tdwgithub/dih-dah-blue/hardware/paddle/Paddle-BOM.csv

Refs | Value | Footprint | Qty | Datasheet
C1 | 0.1uF | Capacitor_THT:C_Disc_D3.0mm_W1.6mm_P2.50mm | 1 | ~
D1 | ~ | LED_THT:LED_D3.0mm_Horizontal_O1.27mm_Z6.0mm | 1 | ~
J1,J4 | Conn_01x02_Pin | Connector_PinHeader_2.54mm:PinHeader_1x02_P2.54mm_Vertical | 2 | ~
J3 | Conn_01x02 | Connector_JST:JST_PH_S2B-PH-K_1x02_P2.00mm_Horizontal | 1 | ~
J5 | Screw_Terminal_01x03 | Wurth:691313510003 | 1 | ~
R1,R2 | 100K | Resistor_THT:R_Axial_DIN0207_L6.3mm_D2.5mm_P10.16mm_Horizontal | 2 | ~
R3 | 1K | Resistor_THT:R_Axial_DIN0207_L6.3mm_D2.5mm_P10.16mm_Horizontal | 1 | ~
SW1,SW2 | SW_Push | Button_Switch_THT:SW_Tactile_SPST_Angled_PTS645Vx83-2LFS | 2 | ~
U1 | XIAO-ESP32-C6 | Seeed Studio XIAO Series Library:XIAO-ESP32C6-DIP | 1
