tdwgithub/dih-dah-blue/hardware/radio/radio-BOM.csv

Refs | Value | Footprint | Qty | Datasheet
Batt1,EN1 | Conn_01x02_Pin | Connector_PinHeader_2.54mm:PinHeader_1x02_P2.54mm_Vertical | 2 | ~
C1,C2 | 100 nF | Capacitor_THT:C_Disc_D5.0mm_W2.5mm_P5.00mm | 2 | ~
C3 | 0.01uF | Capacitor_THT:C_Disc_D3.0mm_W1.6mm_P2.50mm | 1 | ~
D1 | LED | LED_THT:LED_D3.0mm_Horizontal_O1.27mm_Z6.0mm | 1 | ~
D2,D3 | P4KE15CA | Diode_THT:D_DO-41_SOD81_P10.16mm_Horizontal | 2
J1 | Screw_Terminal_01x03 | Wurth:691313510003 | 1 | ~
J3 | Battery | Connector_JST:JST_PH_S2B-PH-K_1x02_P2.00mm_Horizontal | 1 | ~
R1,R2 | 180 ohm | Resistor_THT:R_Axial_DIN0207_L6.3mm_D2.5mm_P10.16mm_Horizontal | 2 | ~
R3 | 1 k | Resistor_THT:R_Axial_DIN0207_L6.3mm_D2.5mm_P10.16mm_Horizontal | 1 | ~
R4,R5 | 10 ohm | Resistor_THT:R_Axial_DIN0207_L6.3mm_D2.5mm_P10.16mm_Horizontal | 2 | ~
SW1,SW2 | SW_Push | Button_Switch_THT:SW_Tactile_SPST_Angled_PTS645Vx83-2LFS | 2 | ~
U1 | XIAO-ESP32-C6 | Seeed Studio XIAO Series Library:XIAO-ESP32C6-DIP | 1
U2 | ASSR-1228-002E | Package_DIP:DIP-8_W7.62mm | 1 | ASSR-1228-002E
