tdwgithub/dih-dah-blue/enclosure/dihdah_blue_enclosure.stl

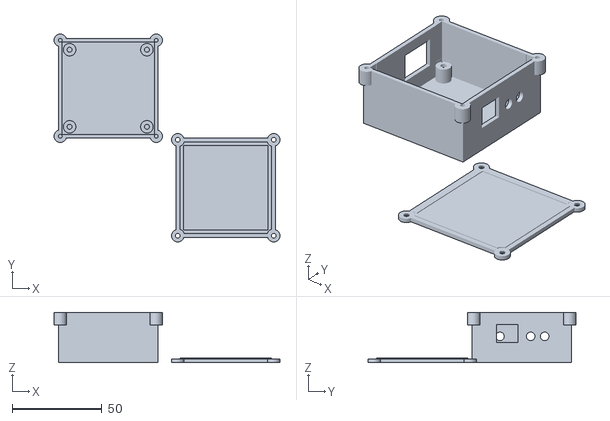
[picture p5: CAD file, 2026-10-20]
enclosure/dihdah_blue_enclosure.stl
125.8 x 115.8 x 28.0
