tdwgithub/dih-dah-blue/hardware/paddle/Paddle-schematic.pdf

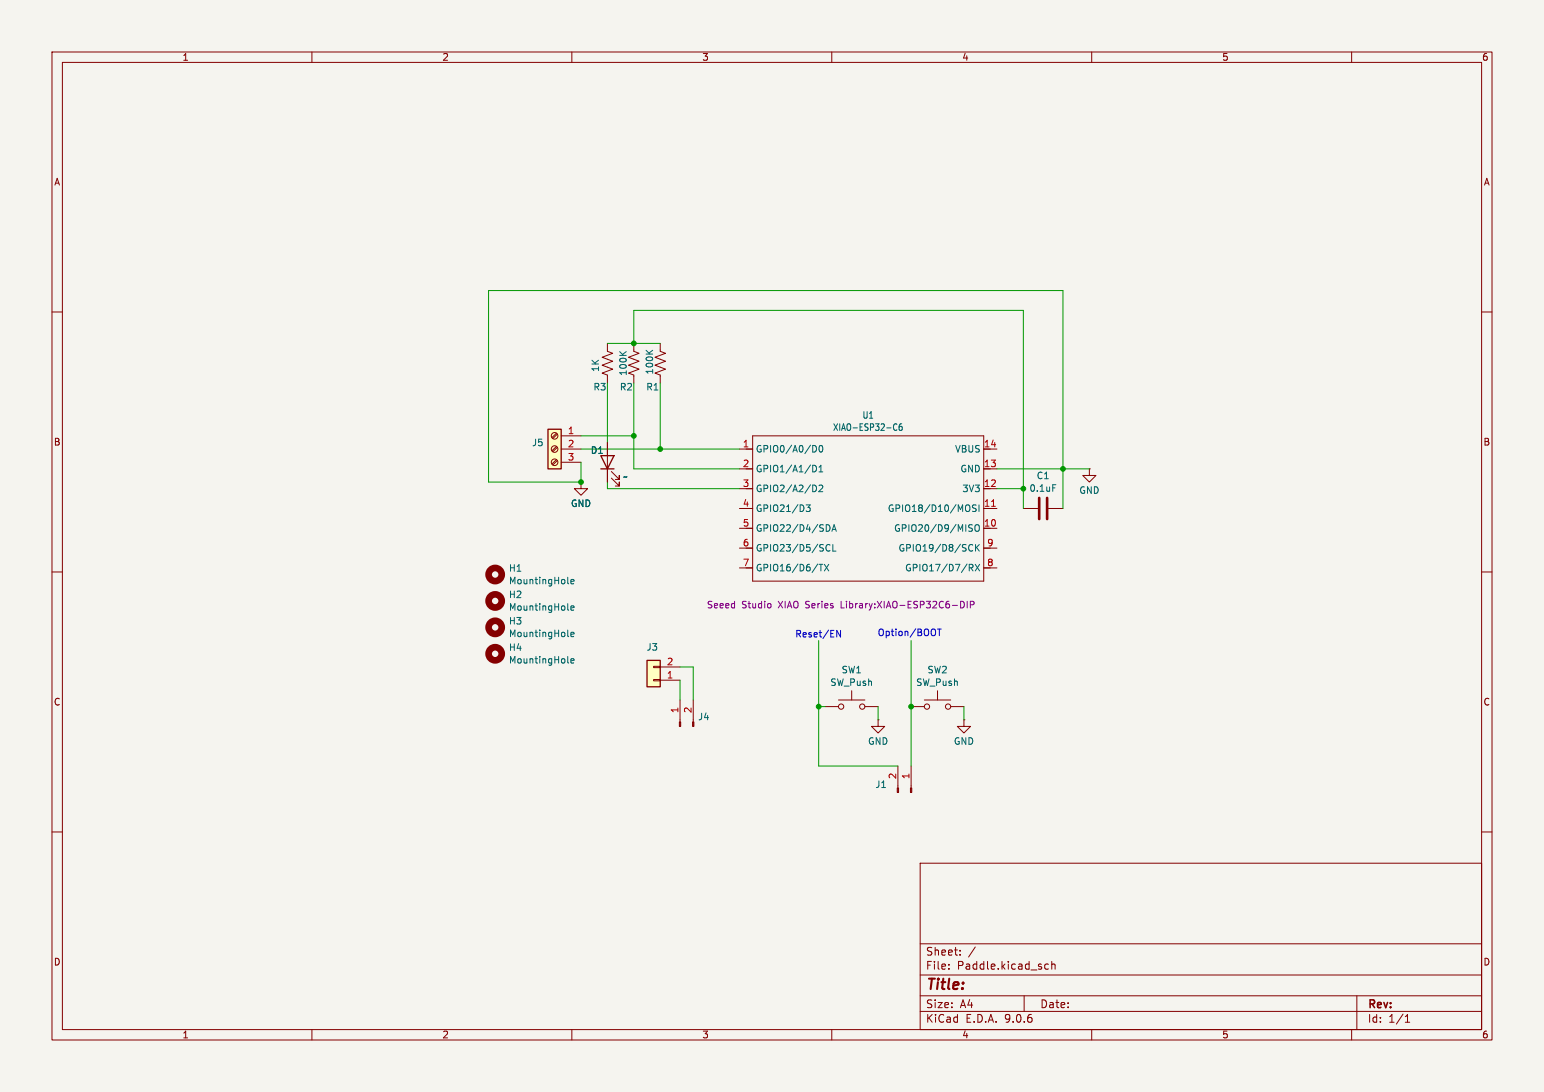
[picture p6: page 1]

Id: 1/1 Title: File: Paddle.kicad_sch Sheet: / 2
