tdwgithub/dih-dah-blue/hardware/radio/radio-schematic.pdf

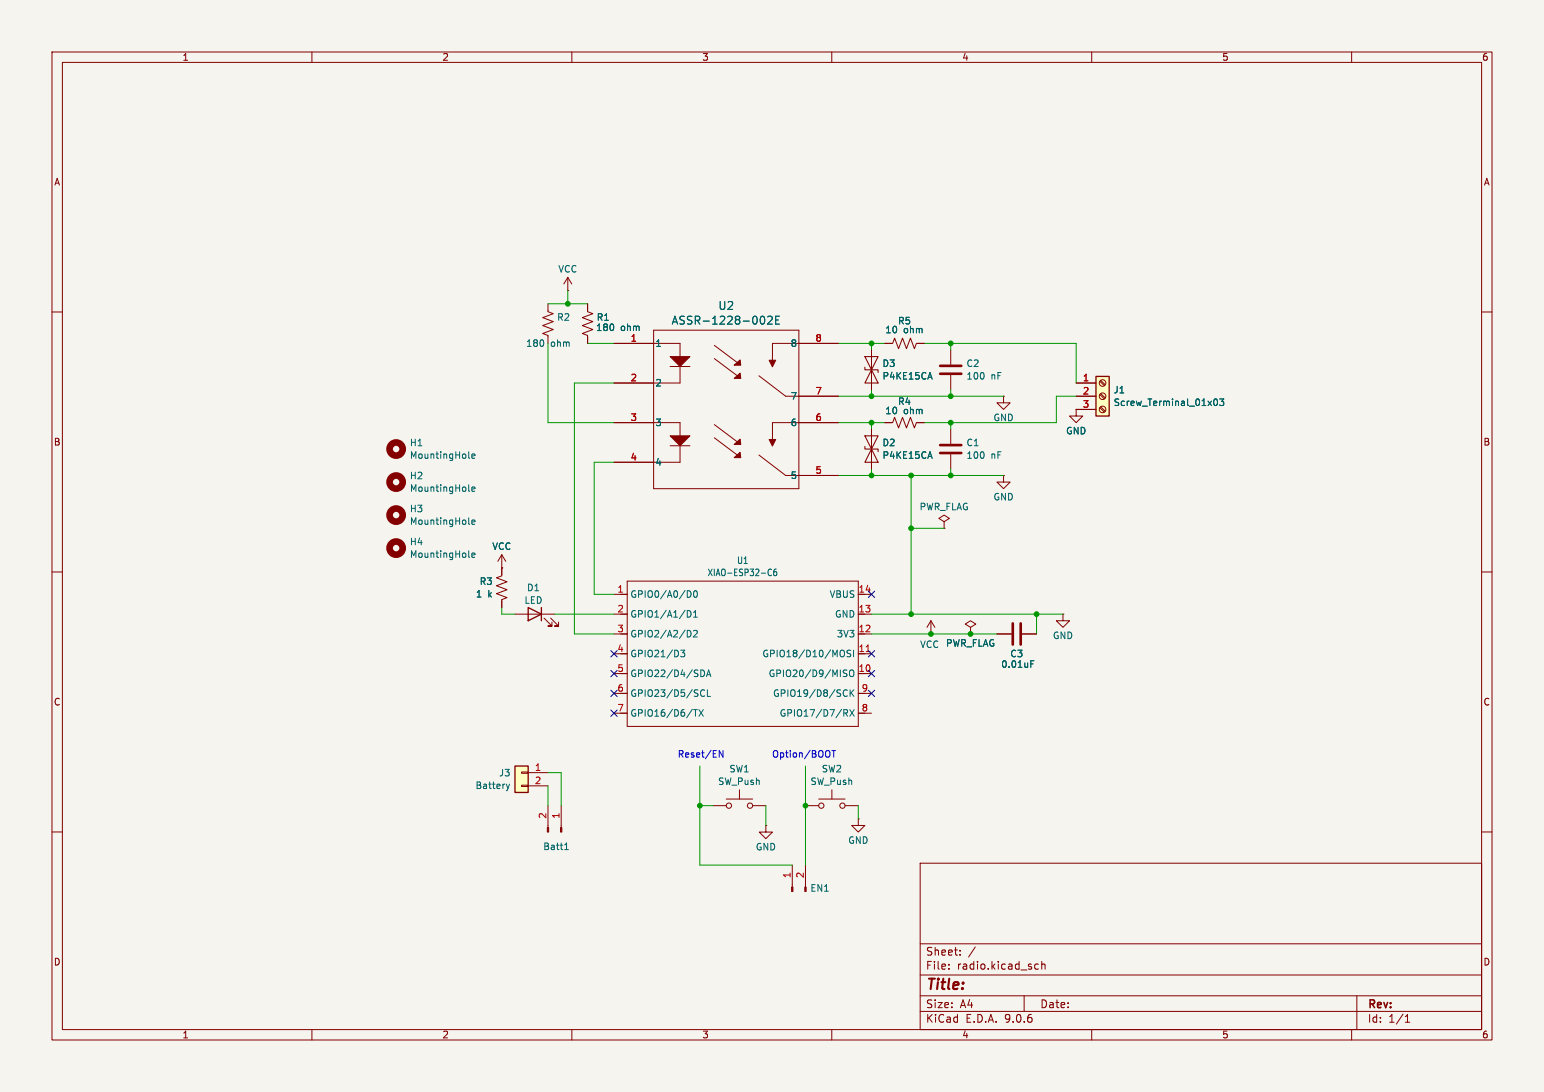
[picture p7: page 1]

Id: 1/1 Title: File: radio.kicad_sch Sheet: /
