tdwgithub/dih-dah-blue/hardware/paddle/Paddle.kicad_pcb

## KiCad design hardware/paddle/Paddle.kicad_pcb (2026-10-20)

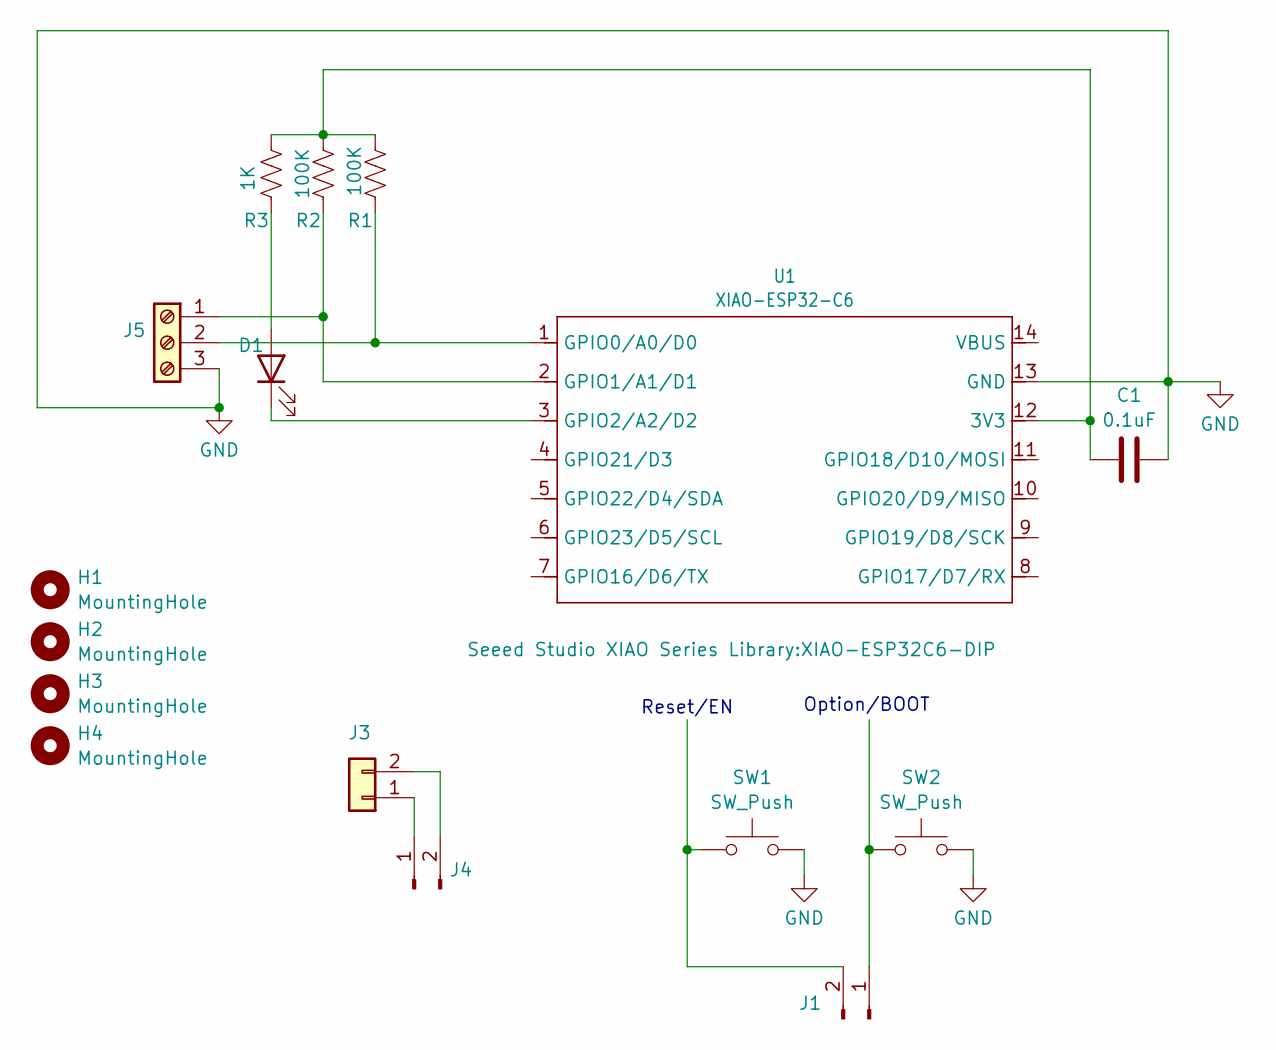
[picture p8: schematic Paddle.kicad_sch]

Parts:
C1: 0.1uF; C_Disc_D3.0mm_W1.6mm_P2.50mm
D1: LED_D3.0mm_Horizontal_O1.27mm_Z6.0mm
H1, H2, H3, H4: MountingHole; MountingHole_3.5mm
J1, J4: Conn_01x02_Pin; PinHeader_1x02_P2.54mm_Vertical
J3: Conn_01x02; JST_PH_S2B-PH-K_1x02_P2.00mm_Horizontal
J5: Screw_Terminal_01x03; 691313510003
R1, R2: 100K; R_Axial_DIN0207_L6.3mm_D2.5mm_P10.16mm_Horizontal
R3: 1K; R_Axial_DIN0207_L6.3mm_D2.5mm_P10.16mm_Horizontal
SW1, SW2: SW_Push; SW_Tactile_SPST_Angled_PTS645Vx83-2LFS
U1: XIAO-ESP32-C6; XIAO-ESP32C6-DIP

Connections:
GND: C1.1, J5.3, SW1.1, SW2.2, U1.13 (GND)
unnamed: D1.2 (A), R3.2
unnamed: D1.1 (K), U1.3 (GPIO2/A2/D2)
unnamed: J1.1, SW2.1
unnamed: J1.2, SW1.2
unnamed: J3.1, J4.1
unnamed: J3.2, J4.2
unnamed: J5.1, R2.2, U1.2 (GPIO1/A1/D1)
unnamed: J5.2, R1.2, U1.1 (GPIO0/A0/D0)
unnamed: C1.2, R1.1, R2.1, R3.1, U1.12 (3V3)

Notes on the sheet:
Reset/EN
Option/BOOT

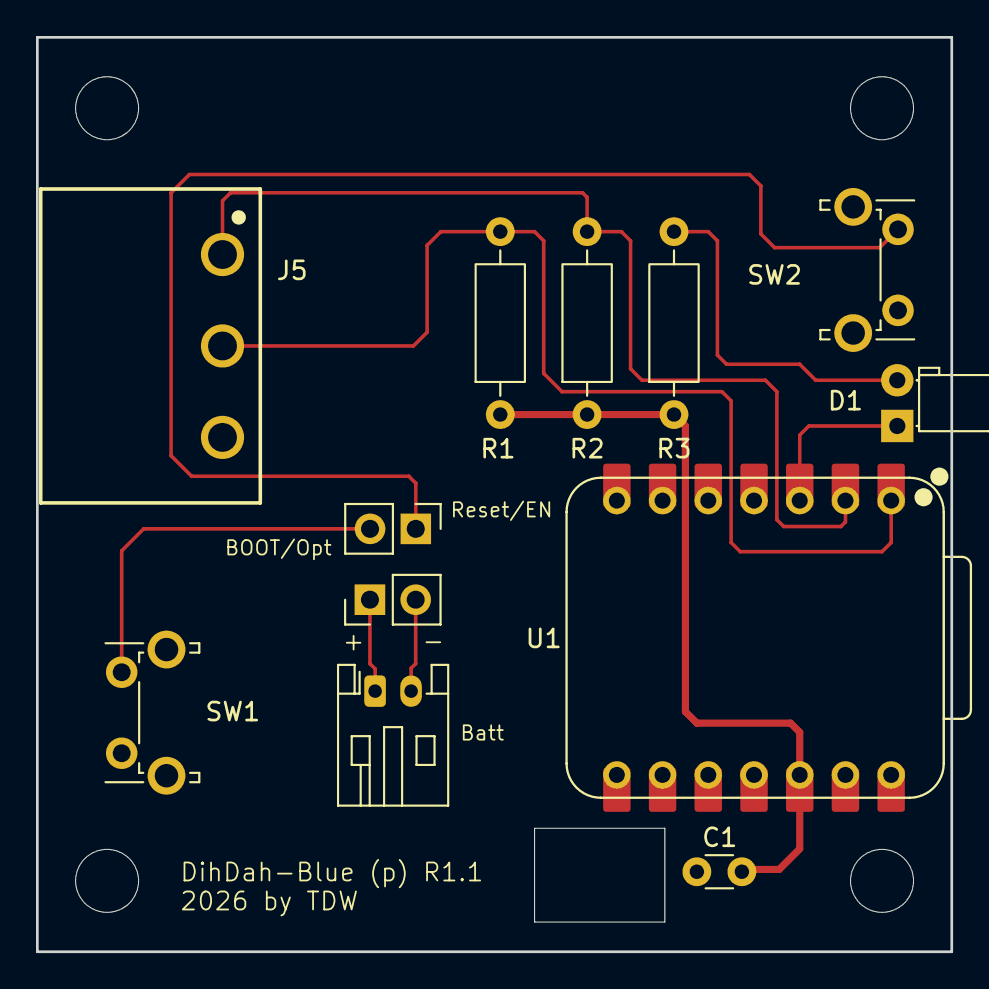
[picture p9: board Paddle.kicad_pcb from above]

Board: 2 copper layers, 50.8 x 50.8 mm, 16 parts (0 on the bottom side), 10 nets.
