tdwgithub/dih-dah-blue/hardware/radio/radio.kicad_pcb

## KiCad design hardware/radio/radio.kicad_pcb (2026-10-20)

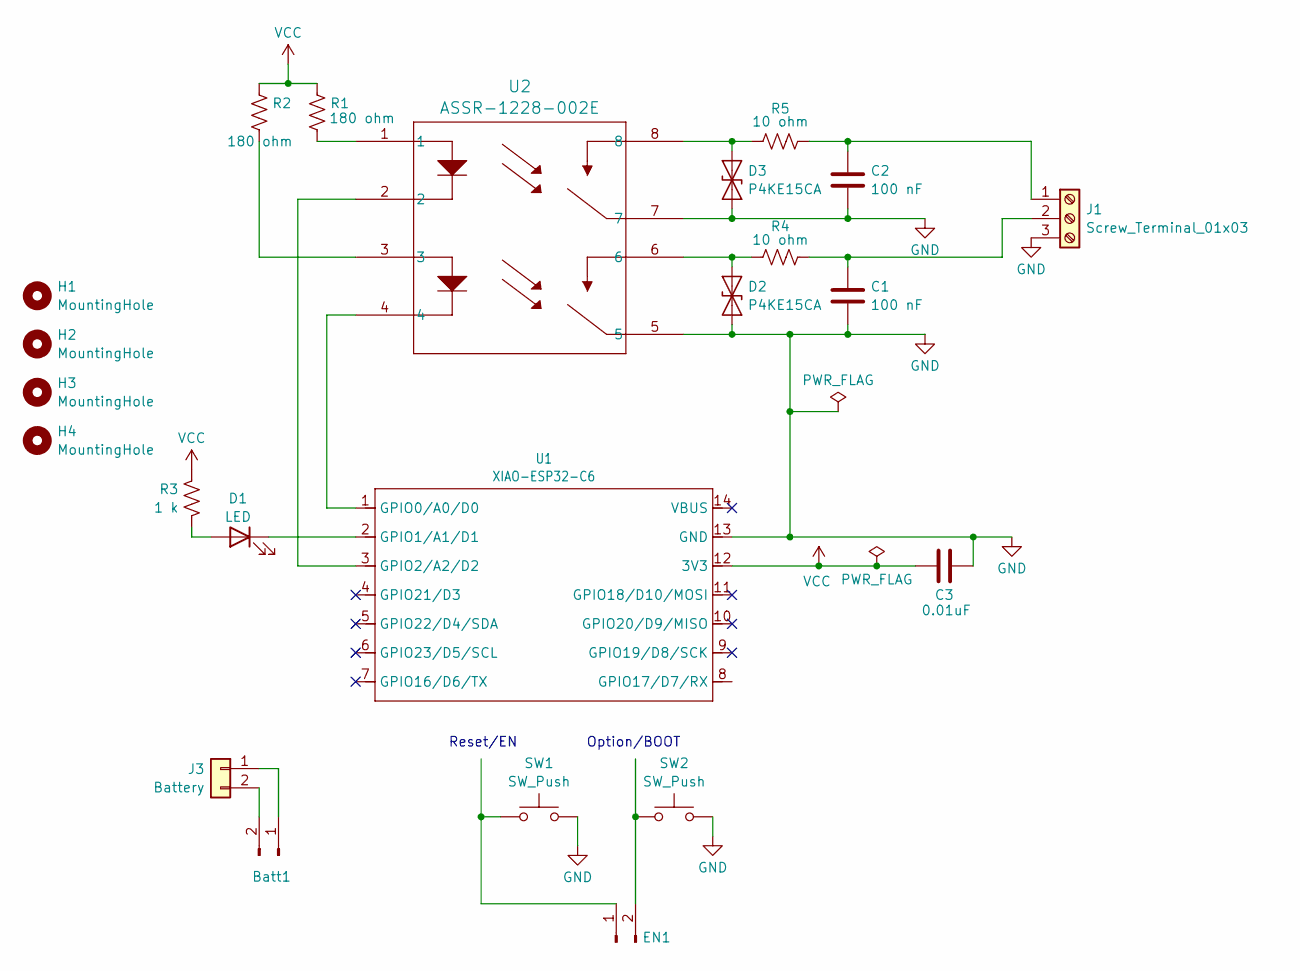
[picture p10: schematic radio.kicad_sch]

Parts:
Batt1: Conn_01x02_Pin; PinHeader_1x02_P2.54mm_Vertical
C1, C2: 100 nF; C_Disc_D5.0mm_W2.5mm_P5.00mm
C3: 0.01uF; C_Disc_D3.0mm_W1.6mm_P2.50mm
D1: LED; LED_D3.0mm_Horizontal_O1.27mm_Z6.0mm
D2, D3: P4KE15CA; D_DO-41_SOD81_P10.16mm_Horizontal
EN1: Conn_01x02_Pin; PinHeader_1x02_P2.54mm_Vertical
H1, H2, H3, H4: MountingHole; MountingHole_3.5mm
J1: Screw_Terminal_01x03; 691313510003
J3: Battery; JST_PH_S2B-PH-K_1x02_P2.00mm_Horizontal
R1, R2: 180 ohm; R_Axial_DIN0207_L6.3mm_D2.5mm_P10.16mm_Horizontal
R3: 1 k; R_Axial_DIN0207_L6.3mm_D2.5mm_P10.16mm_Horizontal
R4, R5: 10 ohm; R_Axial_DIN0207_L6.3mm_D2.5mm_P10.16mm_Horizontal
SW1, SW2: SW_Push; SW_Tactile_SPST_Angled_PTS645Vx83-2LFS
U1: XIAO-ESP32-C6; XIAO-ESP32C6-DIP
U2: ASSR-1228-002E; DIP-8_W7.62mm

Connections:
GND: C1.2, C2.2, C3.1, D2.2 (A2), D3.2 (A2), J1.3, SW1.2, SW2.1, U1.13 (GND), U2.5, U2.7
unnamed: Batt1.1, J3.1
unnamed: Batt1.2, J3.2
unnamed: D1.2 (A), R3.2
unnamed: D1.1 (K), U1.2 (GPIO1/A1/D1)
unnamed: D2.1 (A1), R4.2, U2.6
unnamed: D3.1 (A1), R5.2, U2.8
unnamed: EN1.1, SW1.1
unnamed: EN1.2, SW2.2
unnamed: C2.1, J1.1, R5.1
unnamed: C1.1, J1.2, R4.1
unnamed: R1.2, U2.1
unnamed: R2.2, U2.3
unnamed: U1.1 (GPIO0/A0/D0), U2.4
unnamed: U1.3 (GPIO2/A2/D2), U2.2
VCC: C3.2, R1.1, R2.1, R3.1, U1.12 (3V3)

Notes on the sheet:
Reset/EN
Option/BOOT

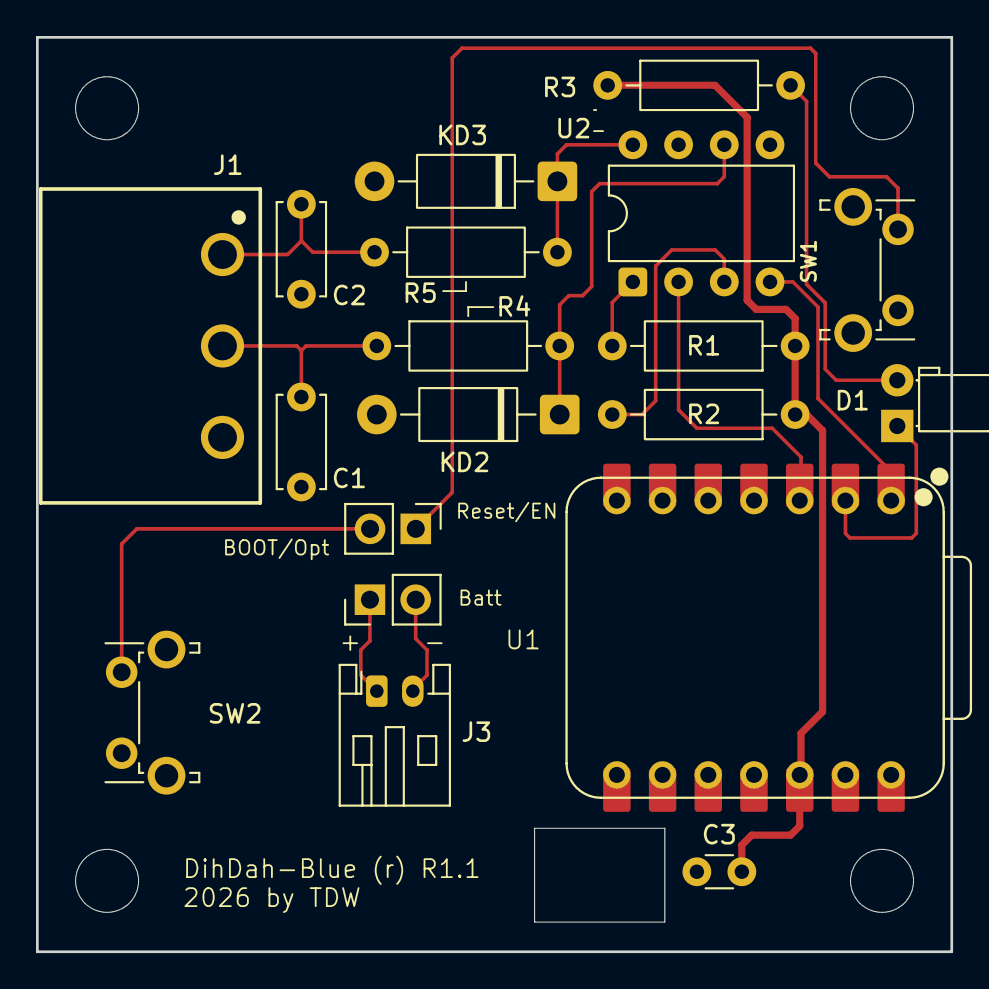
[picture p11: board radio.kicad_pcb from above]

Board: 2 copper layers, 50.8 x 50.8 mm, 23 parts (0 on the bottom side), 16 nets.
